Blinky-Lite-Exchange/blinky-SSR-bake-cube/schematics/kiCad/blinky-SSR-bake.kicad_pcb

## KiCad design schematics/kiCad/blinky-SSR-bake.kicad_pcb (2021-01-25)

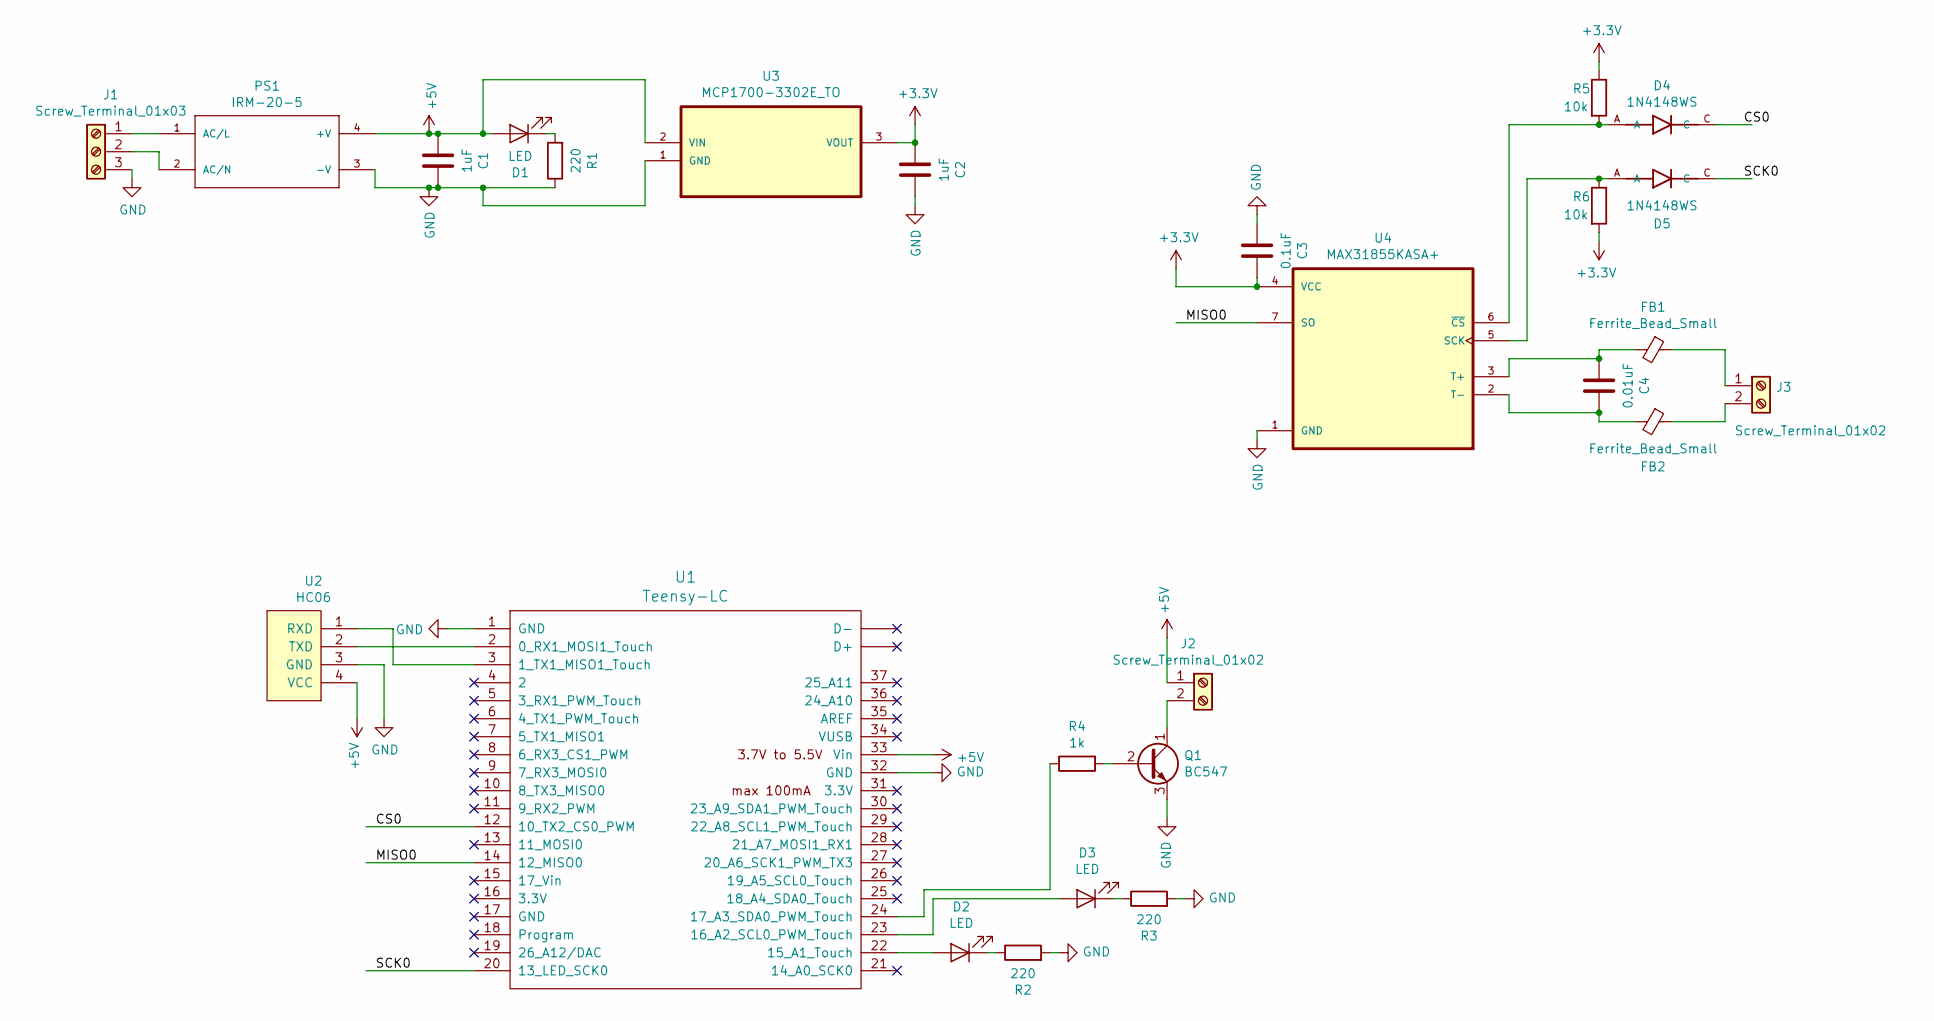
[picture p1: schematic blinky-SSR-bake.sch]

Parts:
C1, C2: 1uF; C_1206_3216Metric_Pad1.42x1.75mm_HandSolder
C3: 0.1uF; C_1206_3216Metric_Pad1.42x1.75mm_HandSolder
C4: 0.01uF; C_1206_3216Metric_Pad1.42x1.75mm_HandSolder
D1, D2, D3: LED; LED_D5.0mm
D4, D5: 1N4148WS; SODFL2512X100N
FB1, FB2: Ferrite_Bead_Small; L_1206_3216Metric_Pad1.42x1.75mm_HandSolder
J1: Screw_Terminal_01x03; TerminalBlock_bornier-3_P5.08mm
J2, J3: Screw_Terminal_01x02; TerminalBlock_bornier-2_P5.08mm
PS1: IRM-20-5; CONV_IRM-20-5
Q1: BC547; TO-92_Inline_Wide
R1, R2, R3: 220; R_1206_3216Metric_Pad1.42x1.75mm_HandSolder
R4: 1k; R_1206_3216Metric_Pad1.42x1.75mm_HandSolder
R5, R6: 10k; R_1206_3216Metric_Pad1.42x1.75mm_HandSolder
U1: Teensy-LC; Teensy30_31_32_LC
U2: HC06
U3: MCP1700-3302E_TO; TO127P254X495-3; MPN MCP1700-3302E/TO
U4: MAX31855KASA+; SOIC127P600X175-8N

Connections:
+3V3: C2.2, C3.1, R5.1, R6.2, U3.3 (VOUT), U4.4 (VCC)
+5V: C1.2, D1.2 (A), J2.1, PS1.4 (+V), U1.33 (Vin), U2.4 (VCC), U3.2 (VIN)
/CS0: D4.C, U1.12 (10_TX2_CS0_PWM)
/MISO0: U1.14 (12_MISO0), U4.7 (SO)
/SCK0: D5.C, U1.20 (13_LED_SCK0)
GND: C1.1, C2.1, C3.2, J1.3, PS1.3 (-V), Q1.3 (E), R1.1, R2.2, R3.2, U1.1 (GND), U1.32 (GND), U2.3 (GND), U3.1 (GND), U4.1 (GND)
unnamed: C4.1, FB2.2, U4.2 (T-)
unnamed: C4.2, FB1.2, U4.3 (T+)
unnamed: D1.1 (K), R1.2
unnamed: D2.1 (K), R2.1
unnamed: D2.2 (A), U1.22 (15_A1_Touch)
unnamed: D3.1 (K), R3.1
unnamed: D3.2 (A), U1.23 (16_A2_SCL0_PWM_Touch)
unnamed: D4.A, R5.2, U4.6 (~CS)
unnamed: D5.A, R6.1, U4.5 (SCK)
unnamed: FB1.1, J3.1
unnamed: FB2.1, J3.2
unnamed: J1.1, PS1.1 (AC/L)
unnamed: J1.2, PS1.2 (AC/N)
unnamed: J2.2, Q1.1 (C)
unnamed: Q1.2 (B), R4.2
unnamed: R4.1, U1.24 (17_A3_SDA0_PWM_Touch)
unnamed: U1.2 (0_RX1_MOSI1_Touch), U2.2 (TXD)
unnamed: U1.3 (1_TX1_MISO1_Touch), U2.1 (RXD)

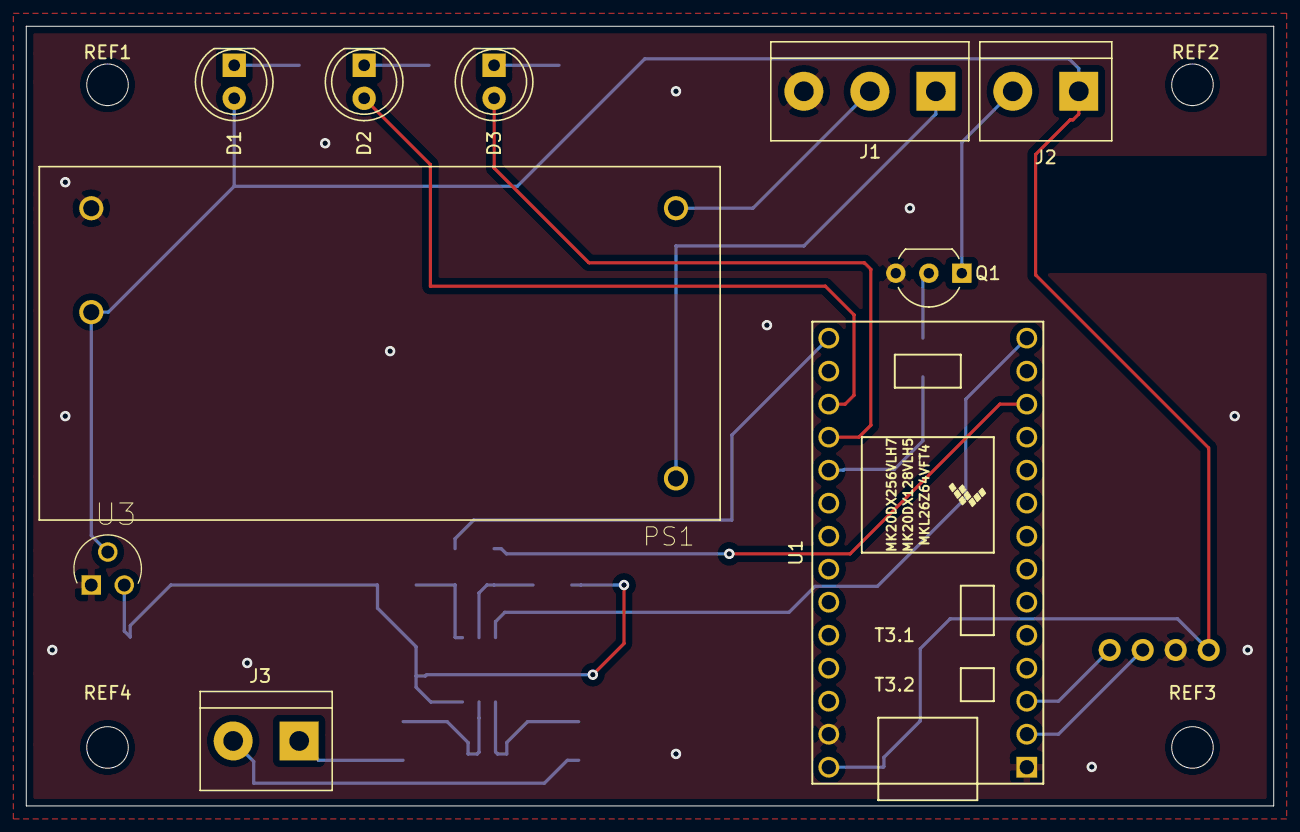
[picture p2: board blinky-SSR-bake.kicad_pcb from above]

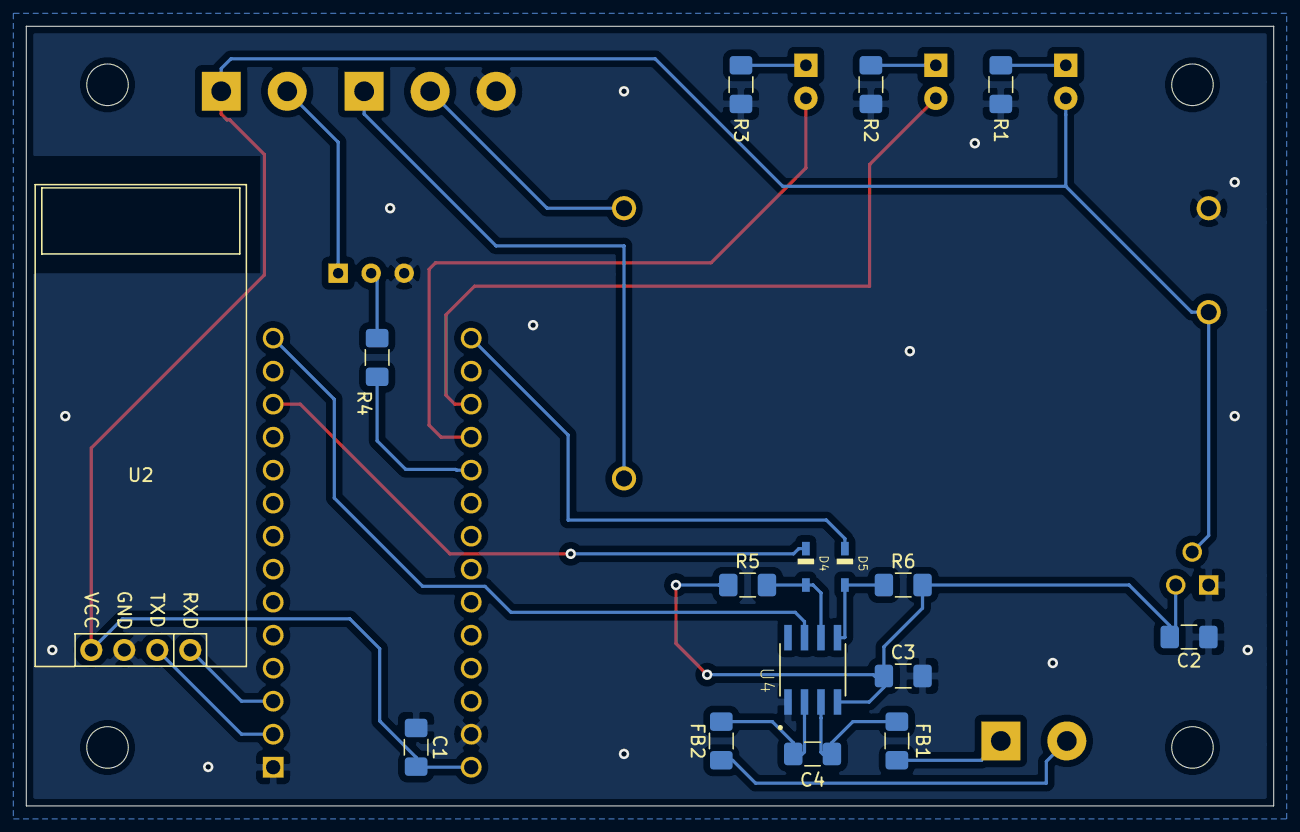
[picture p3: board blinky-SSR-bake.kicad_pcb from below]

Board: 2 copper layers, 96.0 x 60.0 mm, 30 parts (16 on the bottom side), 24 nets.

Other parts of the board:
REF1, REF2, REF3, REF4: MountingHole_3.2mm_M3
