Blinky-Lite-Exchange/blinky-SSR-bake-cube/(commit log)

2021-01-25 circuit designed
    [blinky-SSR.kicad_pcb, blinky-SSR.sch, blinky-lite-basic.kicad_pcb, blinky-lite-basic.sch, blinky-lite-basicBom.csv]
2021-02-08 changed project name
    [blinky-SSR-bake.kicad_pcb, blinky-SSR-bake.sch]
